74ls00/3do/Panasonic_3DO/h_1488953881_7320800_cdd32ba590.jpg

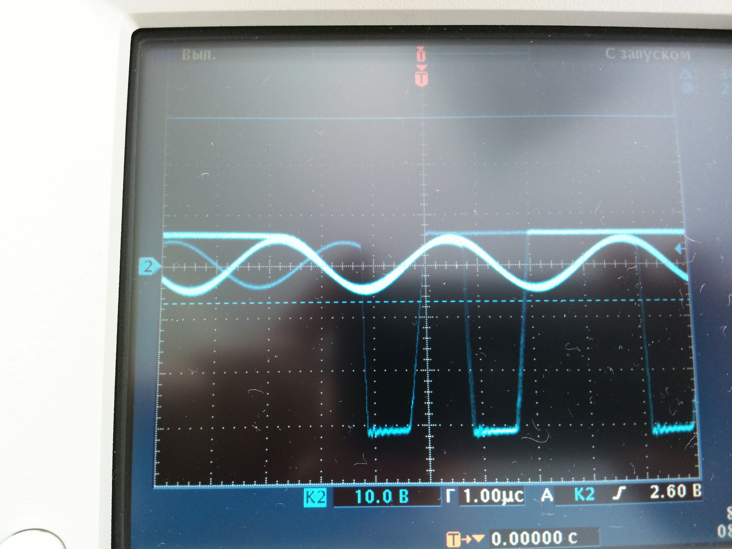
Panasonic_3DO/h_1488953881_7320800_cdd32ba590.jpg
