74ls00/3do/Panasonic_3DO/(220v)Panasonic_3DO_FZ-10_Power_Supply_ETXMM002E2B_NPX002E2-1A_schematic_diagram.pdf

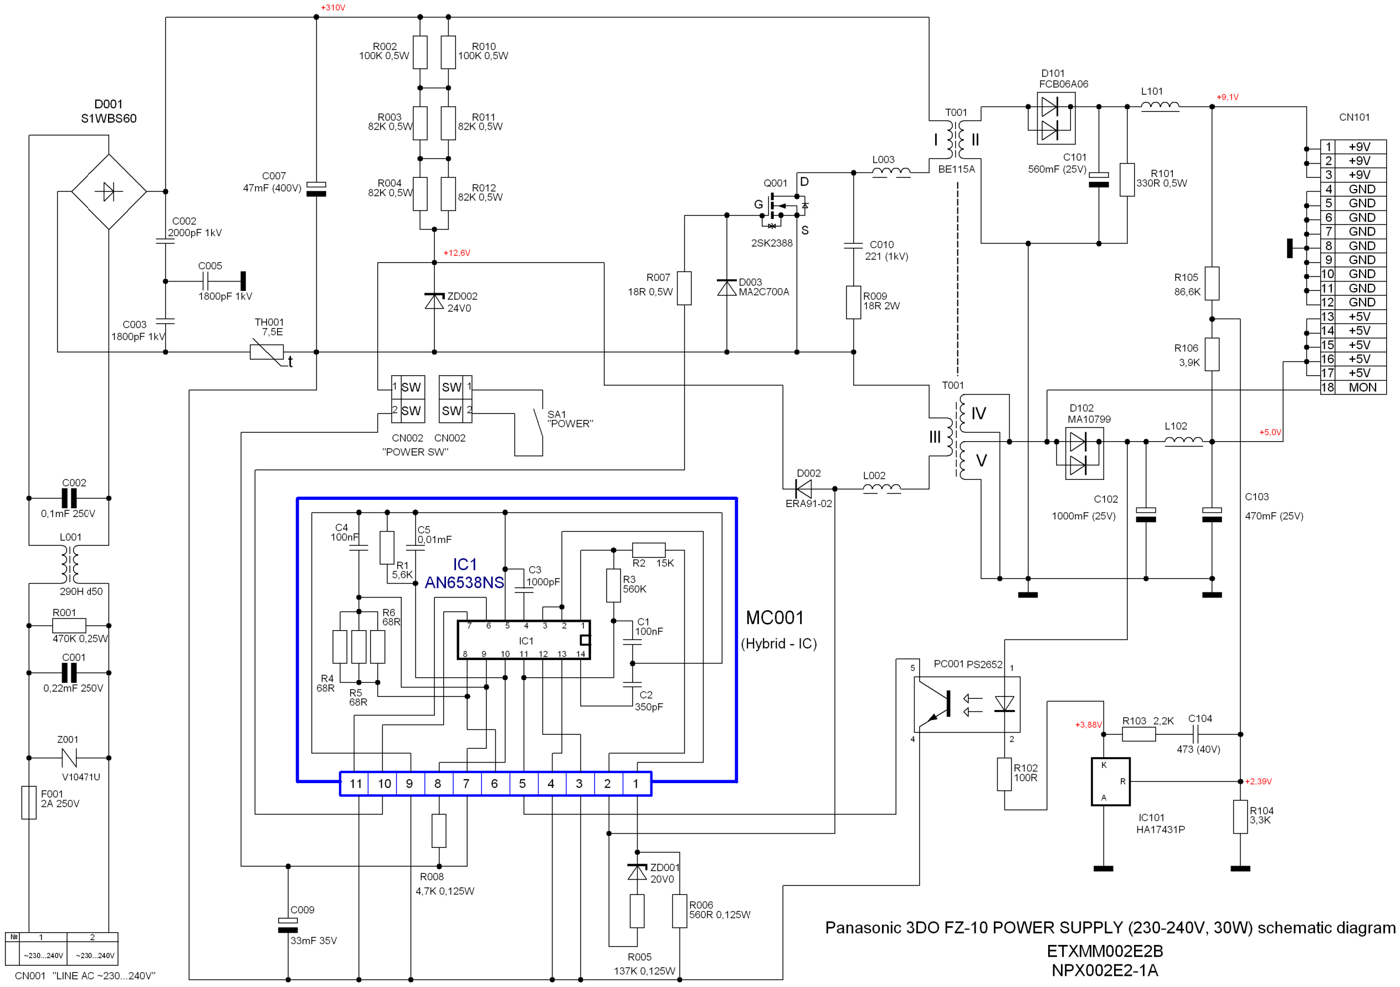
[picture p2: page 1]
