74ls00/3do/200.png

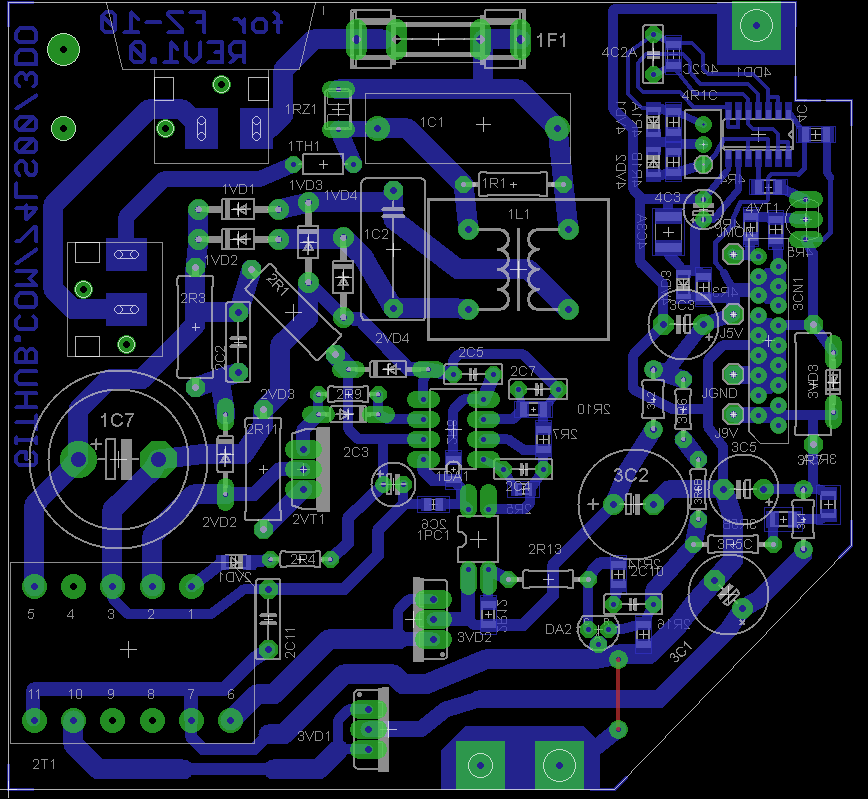
200.png
