74ls00/3do/Flyback/3842.png

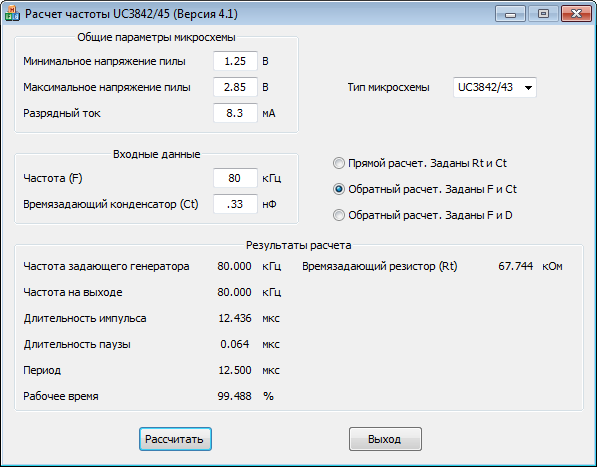
Flyback/3842.png
