74ls00/3do/PNG/100.png

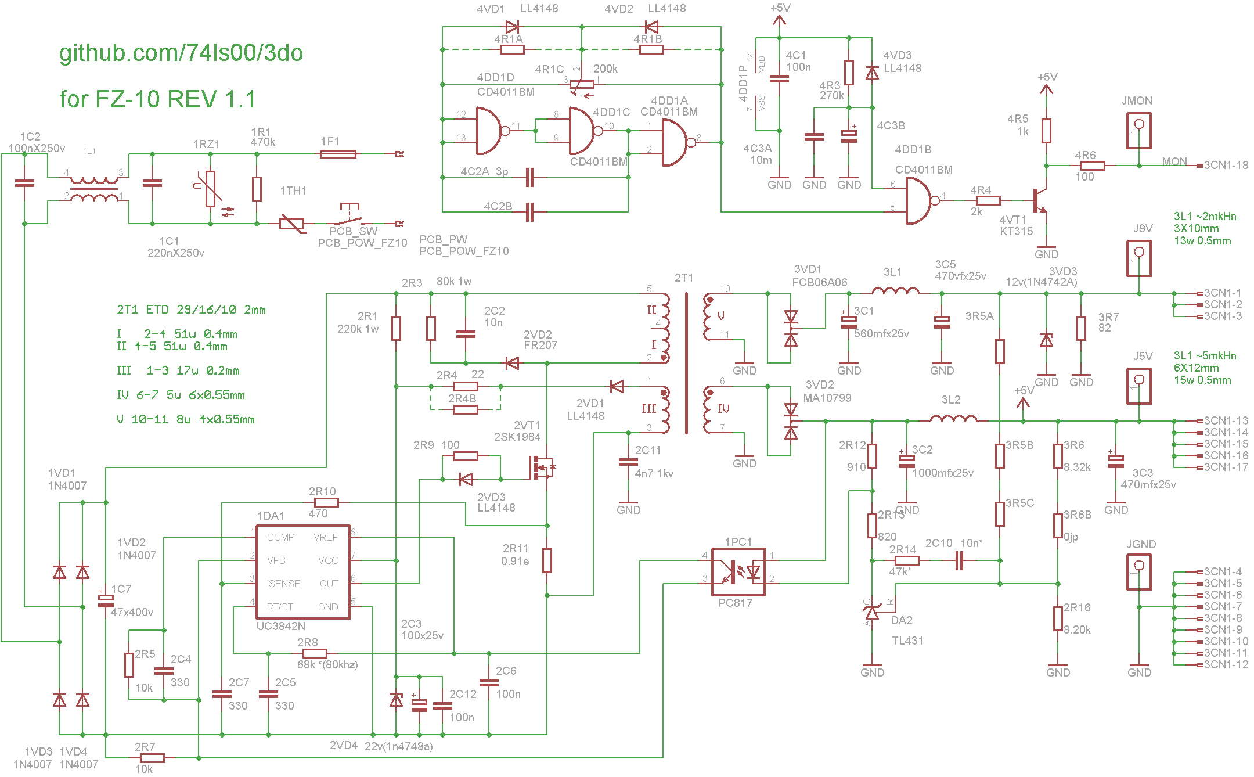
PNG/100.png
