74ls00/3do/PNG/100_cr.png

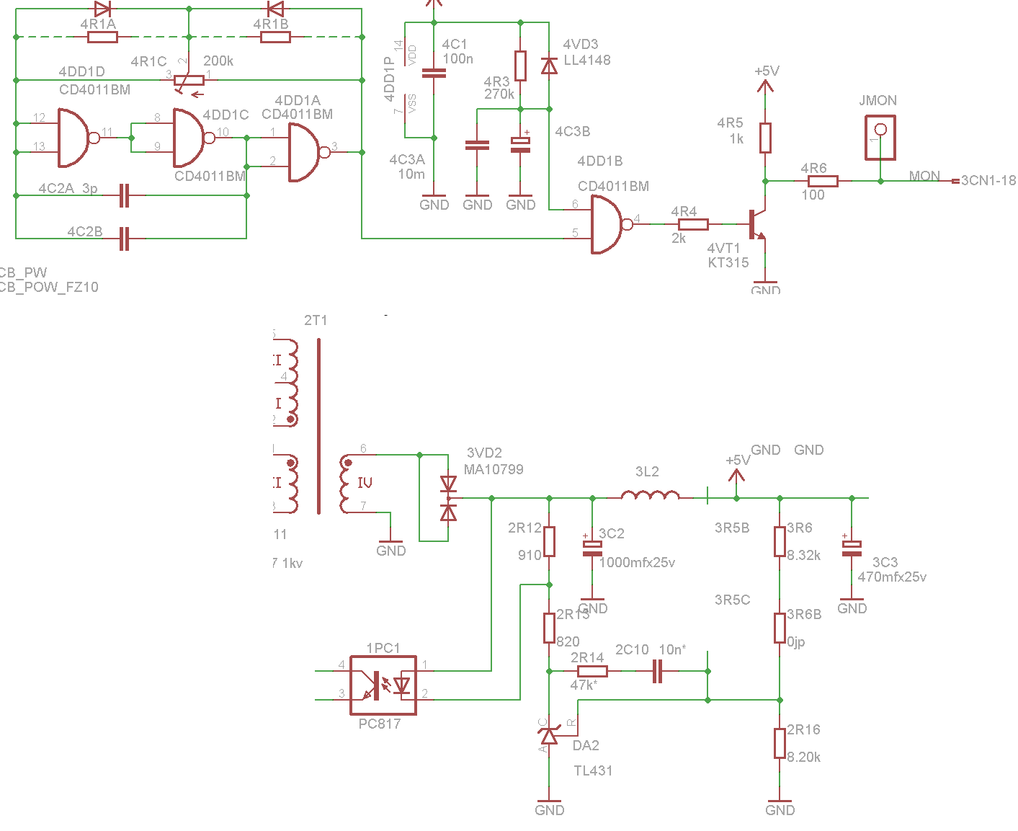
PNG/100_cr.png
