74ls00/3do/PNG/200.png

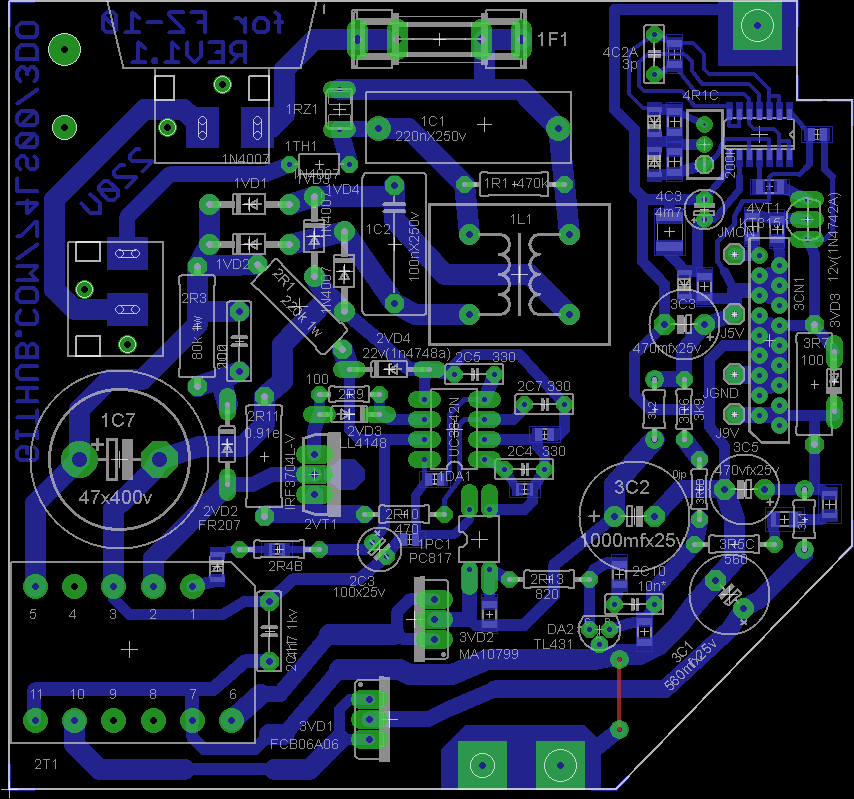
PNG/200.png
