74ls00/3do/PNG/201.png

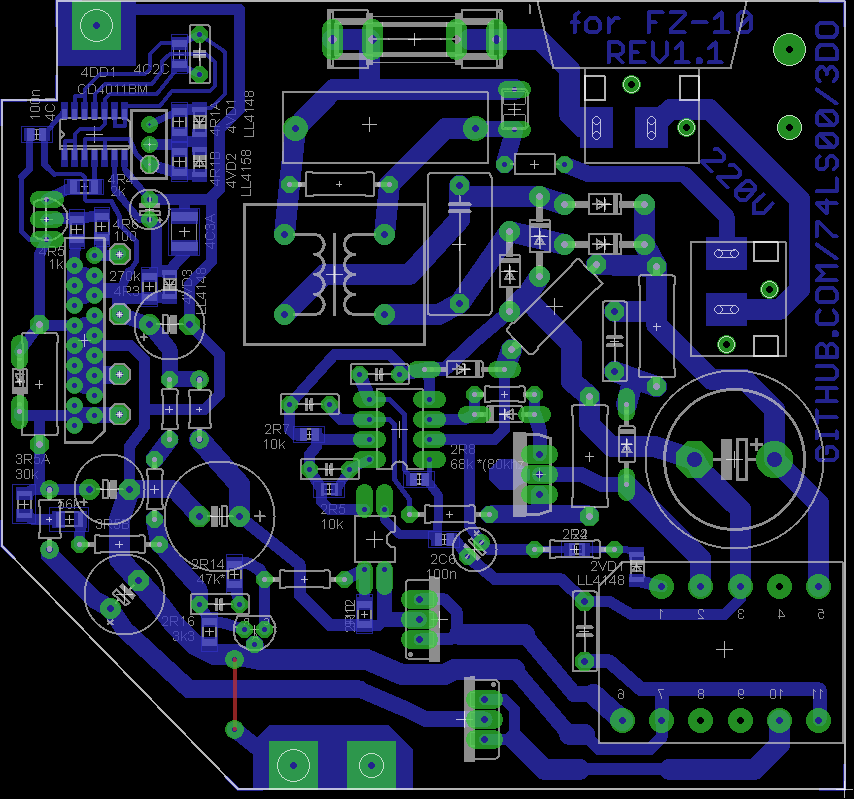
PNG/201.png
