74ls00/3do/fz10_pow.pdf

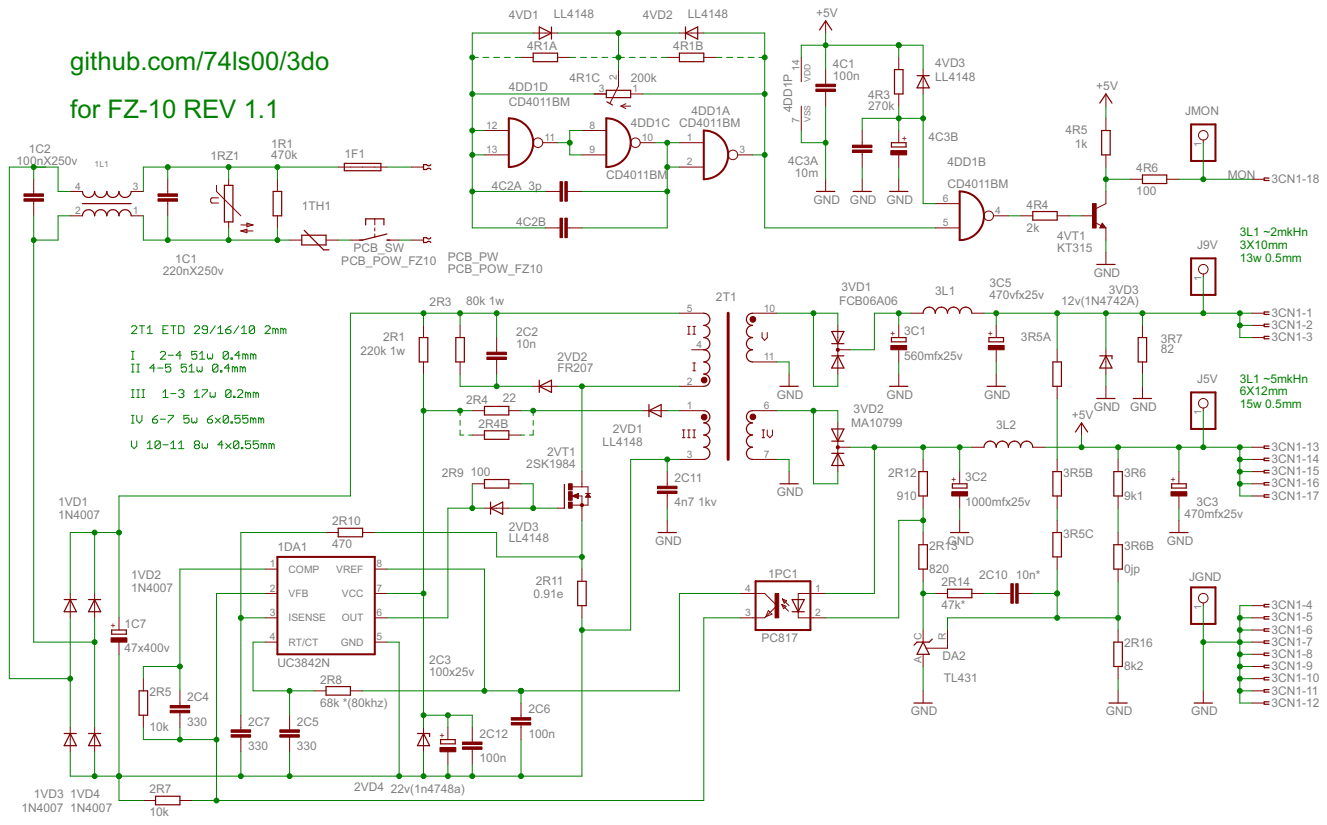
[picture p9: page 1]
