74ls00/3do/(list of files, drawings)

Other design files:
fz10_pow.lay6
