74ls00/3do/fz10_pow.brd

## EAGLE design fz10_pow.brd (2017-04-04)

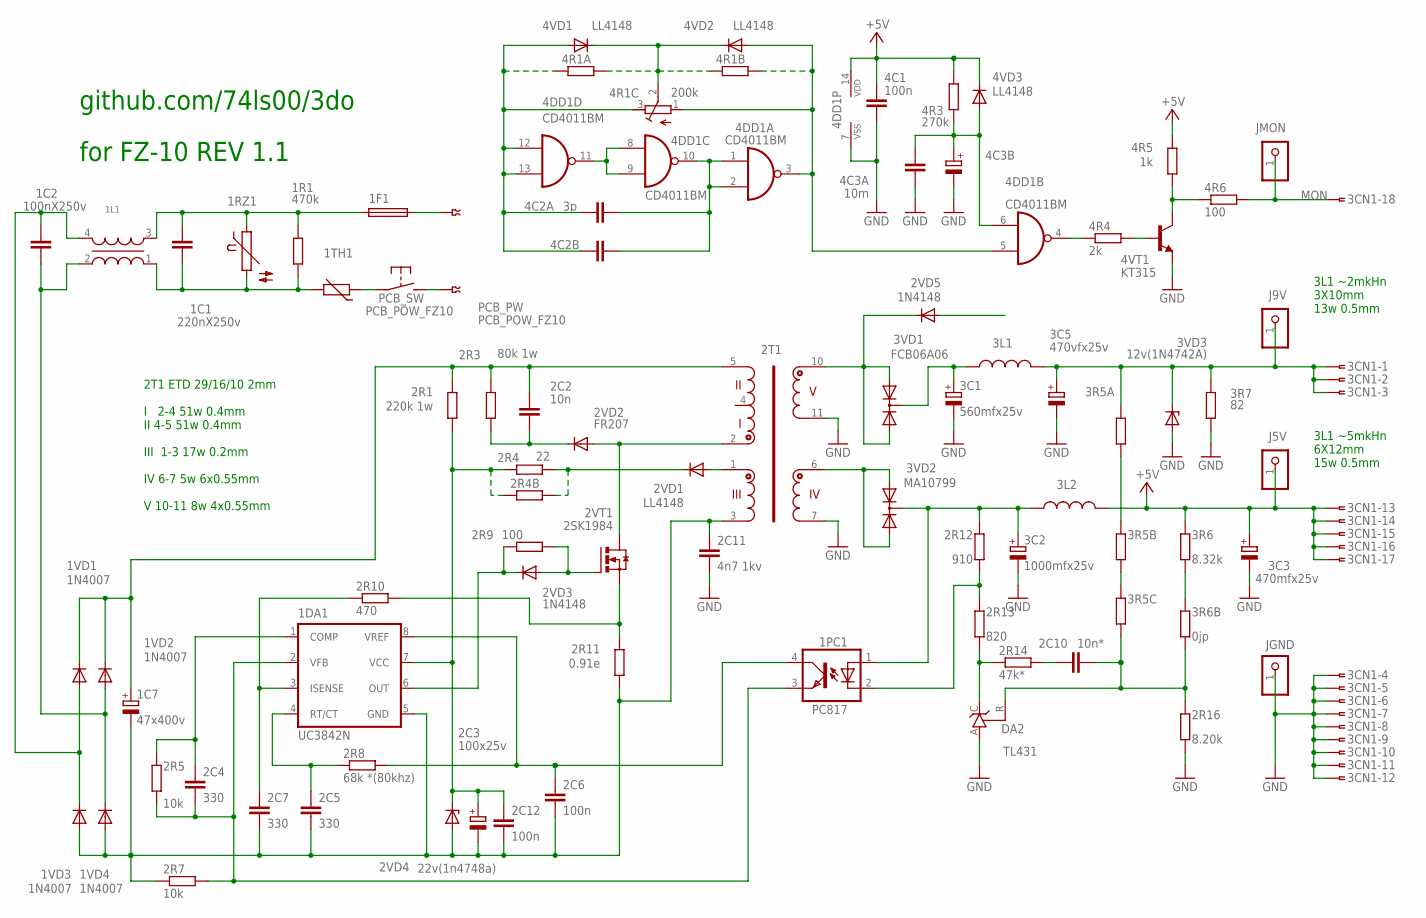
[picture p10: schematic fz10_pow.sch]

Parts:
1C1: 220nX250v; C_26X9
1C2: 100nX250v; C150-084X183
1C7: 47x400v; EB22,5D
1DA1: UC3842N; DIL08
1F1: SHK20L
1L1: LFLF-10X13; LF-10X13
1PC1: PC817; DIL04
1R1: 470k; 0309/12
1RZ1: S1210
1TH1: THERMISTOR-7,5; R-7,5
1VD1, 1VD2, 1VD3, 1VD4: 1N4007; DO41-10
2C2: 10n; C075-032X103
2C3: 100x25v; E2,5-6
2C4, 2C5, 2C7: 330; C050-025X075
2C6, 2C12, 4C1: 100n; C0805
2C10: 10n*; C050-025X075
2C11: 4n7 1kv; C075-032X103
2R1: 220k 1w; P0613/15
2R3: 80k 1w; P0613/15
2R4: 22; M0805
2R4B, 3R5C: R-EU_0207/10; 0207/10
2R5: 10k; M0805
2R7: 10k; R0805
2R8: 68k *(80khz); R0805
2R9: 100; 0204/7
2R10: 470; 0207/10
2R11: 0.91e; P0613/15
2R12: 910; R1206
2R13: 820; 0207/10
2R14: 47k*; R1206
2R16: 8.20k; R1206
2T1: TRANS_ER29; ER29
2VD1, 4VD1, 4VD2, 4VD3: LL4148; SOD80C
2VD2: FR207; DO35-10
2VD3, 2VD5: 1N4148; DO35-7
2VD4: 22v(1n4748a); DO35Z10
2VT1: 2SK1984; TO262-V
3C1: 560mfx25v; E5-10,5
3C2: 1000mfx25v; E5-13
3C3: 470mfx25v; E5-8,5
3C5: 470vfx25v; E5-8,5
3CN1: FTOP-18
3L1, 3L2: L-USTFI0305; TFI0305
3R5A, 3R5B: R-EU_M1206; M1206
3R6: 8.32k; 0204/7
3R6B: 0jp; 0204/7
3R7: 82; P0613/15
3VD1: FCB06A06; TO220ABS
3VD2: MA10799; TO220ABS
3VD3: 12v(1N4742A); DO34Z7
4C2A: 3p; C050-025X075
4C2B: C-EUC1206; C1206
4C3A: 10m; C1812
4C3B: CPOL-EUE2.5-5; E2,5-5
4DD1: CD4011BM; SO14
4R1A, 4R1B: R-EU_R1206; R1206
4R1C: 200k; RTRIM3296W
4R3: 270k; R1206
4R4: 2k; R1206
4R5: 1k; R1206
4R6: 100; R1206
4VT1: KT315; TO92-ECB
DA2: TL431; TO92-CLP
J5V, J9V: PINHD-1X1; 1X01
JGND: PINHD-1X1; 1X01
JMON: PINHD-1X1; 1X01
PCB: PCB_POW_FZ10; POW_FZ10

Connections:
+5V: 3C3.+, 3CN1.13, 3CN1.14, 3CN1.15, 3CN1.16, 3CN1.17, 3L2.2, 3R6.2, 4C1.1, 4DD1.14 (VDD), 4R3.2, 4R5.2, 4VD3.C, J5V.1
+16IN: 1DA1.7 (VCC), 2C3.+, 2C12.1, 2R1.1, 2R4.1, 2R4B.1, 2VD4.C
-IN: 1C7.-, 1DA1.5 (GND), 1VD3.A, 1VD4.A, 2C3.-, 2C5.2, 2C6.2, 2C7.2, 2C11.1, 2C12.2, 2R7.1, 2R11.1, 2T1.3 (OP2), 2VD4.A
GND: 2C11.2, 2R16.1, 2T1.7 (O2.2), 2T1.11 (9V2), 3C1.-, 3C2.-, 3C3.-, 3C5.-, 3CN1.4, 3CN1.5, 3CN1.6, 3CN1.7, 3CN1.8, 3CN1.9, 3CN1.10, 3CN1.11, 3CN1.12, 3R7.1, 3VD3.A, 4C1.2, 4C3A.2, 4C3B.-, 4DD1.7 (VSS), 4VT1.E, DA2.A, JGND.1
MON: 3CN1.18, 4R6.2, JMON.1
unnamed: 4C2A.2, 4C2B.2, 4DD1.12 (I0), 4DD1.13 (I1), 4R1A.1, 4R1C.3 (E), 4VD1.A
unnamed: 4DD1.8 (I0), 4DD1.9 (I1), 4DD1.11 (O)
unnamed: 1DA1.4 (RT/CT), 2C5.1, 2R8.1
unnamed: 1DA1.3 (ISENSE), 2C7.1, 2R10.1
unnamed: 2T1.10 (9V1), 2VD5.C, 3VD1.A1, 3VD1.A2
unnamed: 1DA1.1 (COMP), 2C4.1, 2R5.2
unnamed: 4DD1.3 (O), 4DD1.5 (I0), 4R1B.2, 4R1C.1 (A), 4VD2.A
unnamed: 1DA1.6 (OUT), 2R9.1, 2VD3.C
unnamed: 1TH1.1, PCB.SW1
unnamed: 4R1A.2, 4R1B.1, 4R1C.2 (S), 4VD1.C, 4VD2.C
unnamed: 2R9.2, 2VD3.A, 2VT1.1 (G)
unnamed: 1PC1.2 (C), 2R12.1, 2R13.2
unnamed: 1PC1.1 (A), 2R12.2, 3C2.+, 3L2.1, 3VD2.C
unnamed: 2R13.1, 2R14.1, DA2.C
unnamed: 1C2.1, 1L1.4, 1VD1.A, 1VD3.C
unnamed: 2C10.2, 2R14.2
unnamed: 2T1.2 (IN2), 2VD2.A, 2VT1.2 (D)
unnamed: 1F1.1A, PCB.POW2 (2)
unnamed: 4C2A.1, 4C2B.1, 4DD1.1 (I0), 4DD1.2 (I1), 4DD1.10 (O)
unnamed: 1DA1.8 (VREF), 1PC1.4 (COL), 2C6.1, 2R8.2
unnamed: 2R10.2, 2R11.2, 2VT1.3 (S)
unnamed: 2R4.2, 2R4B.2, 2VD1.C
unnamed: 1C7.+, 1VD1.C, 1VD2.C, 2C2.1, 2R1.2, 2R3.2, 2T1.5 (IN1)
unnamed: 2T1.1 (OP1), 2VD1.A
unnamed: 4DD1.4 (O), 4R4.1
unnamed: 4R4.2, 4VT1.B
unnamed: 3R5A.1, 3R5B.2
unnamed: 2T1.6 (O2.1), 3VD2.A1, 3VD2.A2
unnamed: 4R5.1, 4R6.1, 4VT1.C
unnamed: 2C2.2, 2R3.1, 2VD2.C
unnamed: 1C1.2, 1L1.1, 1R1.1, 1RZ1.2, 1TH1.2
unnamed: 1C1.1, 1F1.2A, 1L1.3, 1R1.2, 1RZ1.1
unnamed: PCB.POW1 (1), PCB.SW2 (S)
unnamed: 4C3A.1, 4C3B.+, 4DD1.6 (I1), 4R3.1, 4VD3.A
unnamed: 3C5.+, 3CN1.1, 3CN1.2, 3CN1.3, 3L1.2, 3R5A.2, 3R7.2, 3VD3.C, J9V.1
unnamed: 3C1.+, 3L1.1, 3VD1.C
unnamed: 1DA1.2 (VFB), 1PC1.3 (EMIT), 2C4.2, 2R5.1, 2R7.2
unnamed: 3R5B.1, 3R5C.2
unnamed: 2C10.1, 2R16.2, 3R5C.1, 3R6B.1, DA2.R
unnamed: 3R6.1, 3R6B.2
unnamed: 1C2.2, 1L1.2, 1VD2.A, 1VD4.C

Notes on the sheet:
github.com/74ls00/3do
for FZ-10 REV 1.1
2T1 ETD 29/16/10 2mm I 2-4 51w 0.4mm II 4-5 51w 0.4mm III 1-3 17w 0.2mm IV 6-7 5w 6x0.55mm V 10-11 8w 4x0.55mm
3L1 ~2mkHn 3X10mm 13w 0.5mm
3L1 ~5mkHn 6X12mm 15w 0.5mm

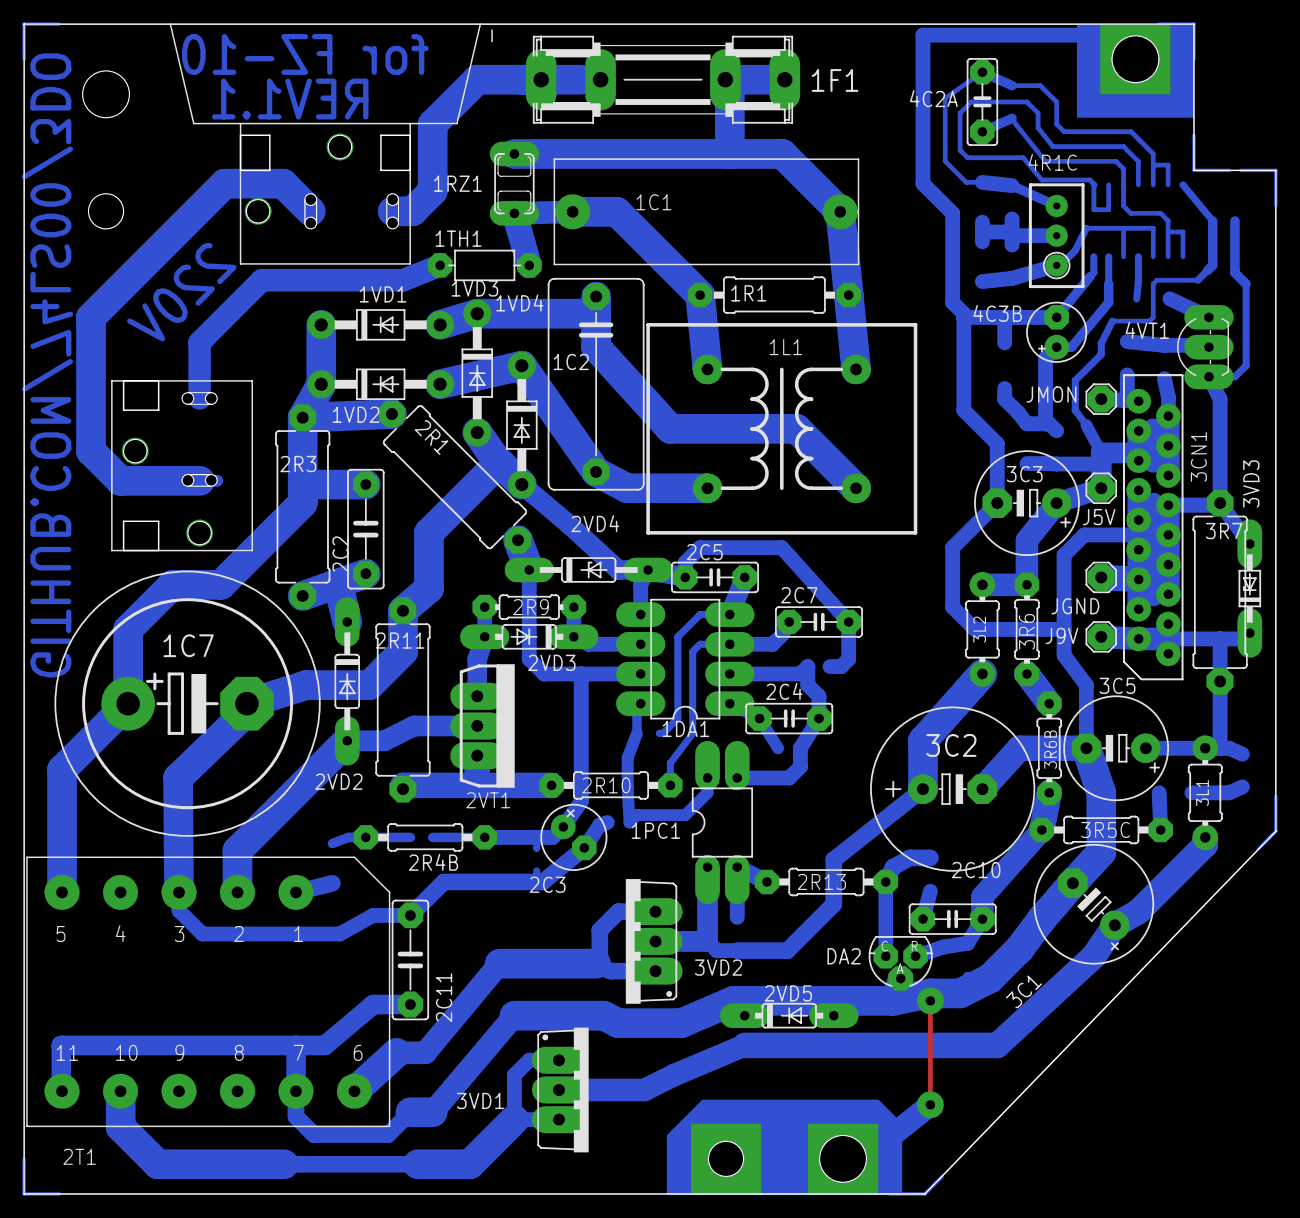
[picture p11: board fz10_pow.brd from above]

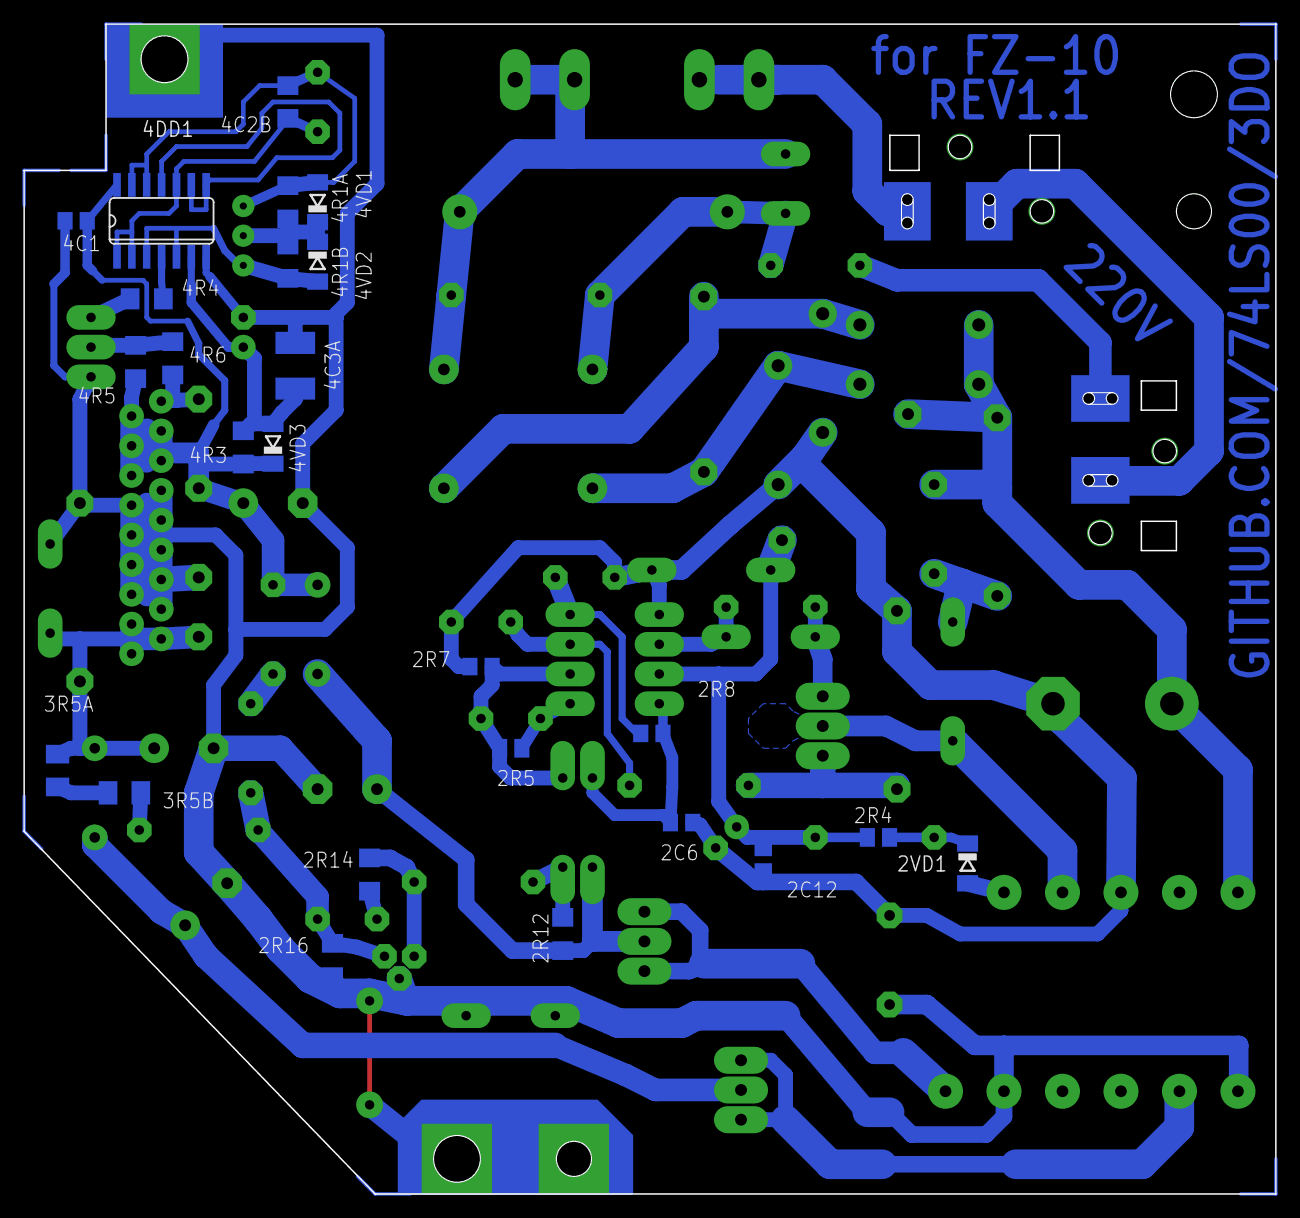
[picture p12: board fz10_pow.brd from below]

Board: 2 copper layers, 107.0 x 100.0 mm, 83 parts (25 on the bottom side), 46 nets.
